dsprz/Swarm-bots/README.md

# Swarm-bots
Projet de robotique. Essaim de robots avec un chef : une araignée.
