dsprz/Swarm-bots/Rapports de séance/VU/Seance_18_VU.md

Séance 18

<p>J'ai réassemblé mon robot avec les rainures en T, qui m'a l'air beaucoup plus solide que les anciens modèles.
J'en ai aussi profité pour retirer le servomoteur qui me permettait de "coller" la pince à mon robot à travers un trou rectangulaire, parce que finalement il n'avait aucune autre utilité. Je ne l'utilisais pas dans mes tests et je ne compte pas l'utiliser plus tard. 
</p>
<p>Du coup, je dois maintenant trouver une solution pour accrocher ma pince. Ma première idée était d'utiliser le pistolet à colle, sauf que ça ne marchait pas : la colle ne prenait pas, et même si elle prenait, je doute qu'elle aurait tenu longtemps.
Ma deuxième idée était de faire deux trous dans le support de ma pince et dans la face avant du robot, et je les assemble avec des vis. Cette idée marche beaucoup mieux: ma pince tient bien en place.
</p> 
<p>Résultat: j'économise un servomoteur et je réduis un peu la longueur et le poids totaux de ma pince, ce qui devrait jouer sur la petite inclinaison que j'avais au niveau de ma pince, et aussi sur la robustesse de mon robot</p>.
