dsprz/Swarm-bots/Rapports de séance/VU/Seance_14._VU.md

<p align="center"><h1>Séance 14</h1><p>

J'ai commencé à monter un premier récepteur. Ci-dessous le schéma électrique du récepteur :
<p align="center">
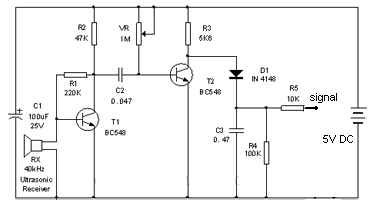
[picture p3: Rapports de séance/VU/images/Seance14/receiver.jpg]
    
</p>
<p align="center">
    <i>Figure 1: Schéma électrique du récepteur</i>
</p>

En faisant les branchements pour faire un premier test  sur la breadboard, j'ai fait beaucoup d'erreurs de branchement parce que j'ai passé beaucoup de temps à souder l'émetteur et je commençais à confondre les connections de la breadboard et celles que j'allais réaliser avec de l'étain. J'ai corrigé les erreurs de branchement.

Après avoir corrigé tous les branchements, j'ai fait mes premiers tests avec le duo émetteur-récepteur. Grâce à Ronan, j'ai réalisé que la soudure de l'émetteur avait un court-circuit. J'avais un signal qui sortait et qui semblait être bon (parce que je pensais que du fait que j'utilise un transistor légèrement différent de celui qui est sur le schéma électrique, le signal allait être un peu différent), sauf que ce n'était pas du tout le bon signal.
J'ai enlevé le court-circuit, mais il n'y avait plus de signal. Après avoir regardé les tensions sur à peu près tous les composants, j'ai vu qu'étrangement la tension aux bornes du condensateur 22nF était de 0V. J'ai désoudé ce-dernier et je l'ai remplacé par un nouveau.
La tension aux bornes du condensateur n'est plus de 0. Résultat : le signal en sortie de l'émetteur est parfait, comme on peut le voir en comparant les signaux suivants :

<p align="center">
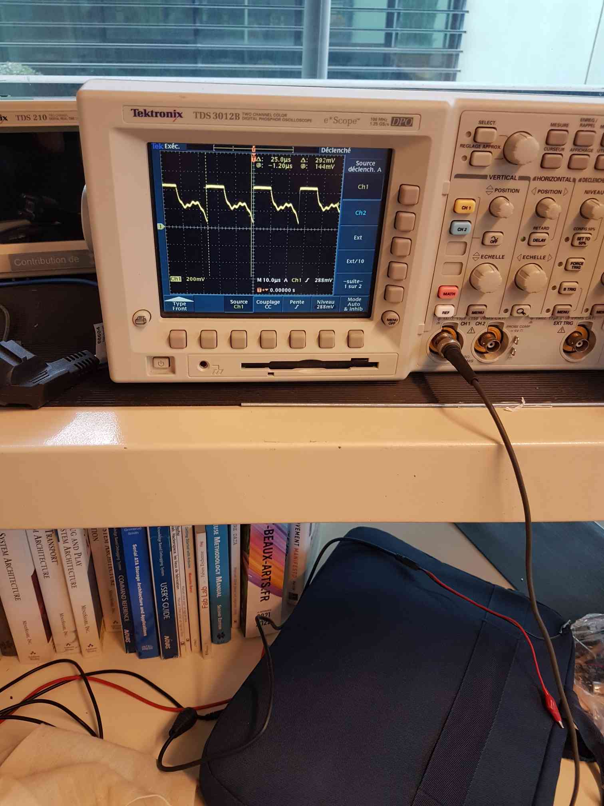
[picture p4: Rapports de séance/VU/images/Seance14/emitter_output.jpg]
    
</p>

<p align="center">
    <i>Figure 2: Signal en sortie de mon émetteur</i>
</p>

<p align="center">
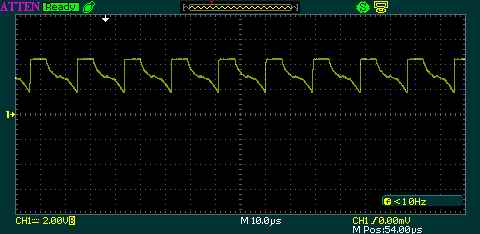
[picture p5: Rapports de séance/VU/images/Seance14/emitter_output_dog.jpg]
    
</p>

<p align="center">
    <i>Figure 3: Signal en sortie de l'émetteur que je suis censé avoir</i>
</p>
La différence entre les deux signaux peut s'expliquer par mes transistors qui sont différents de ceux du schéma électrique de l'émetteur (Séance 13).

En continuant les tests, en plaçant l'émetteur en face du récepteur, j'obtiens le signal ci-dessous avant la diode de l'émetteur :
<p align="center">
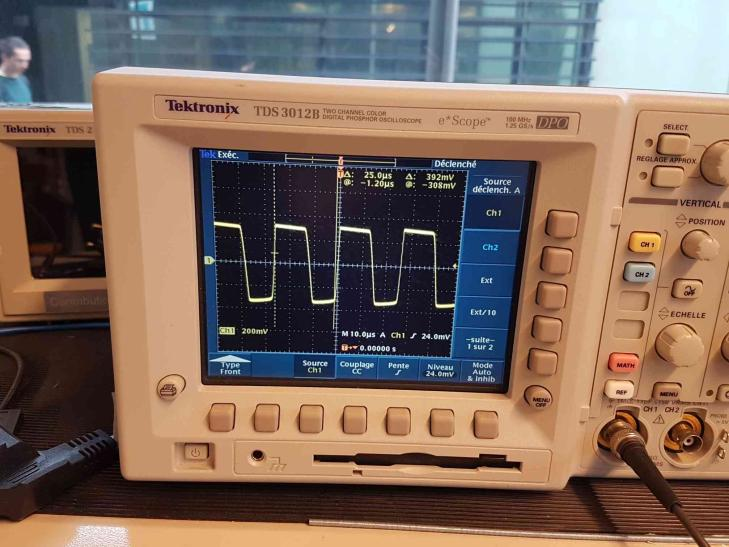
[picture p6: Rapports de séance/VU/images/Seance14/signal_received_diode_me.jpg]
    
</p>
<p align="center">
    <i>Figure 4: Signal que mon récepteur reçoit</i>
</p>

Et voici le signal que je suis censé obtenir :
<p align="center">
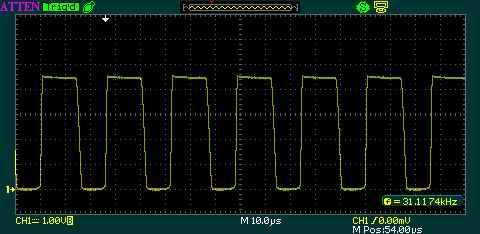
[picture p7: Rapports de séance/VU/images/Seance14/signal_received_diode_dog.jpg]
    
</p>
<p align="center">
    <i>Figure 3: Signal que je suis censé obtenir</i>
</p>

J'obtiens un résultat très satisfaisant.
Lorsque je lis le signal sur le fil Signal du schéma électrique, j'obtiens une tension qui varie en fonction de la distance entre l'émetteur et le récepteur.

Je peux alors retirer les composants de la breadboard et les souder. Après avoir fait ça, j'ai remarqué que le signal reçu faiblit trop vite. Il faut donc que je concentre les ondes, par exemple dans un tube, afin "d'amplifier la tension reçue" pour qu'elle soit perceptible par les pins analogiques d'Arduino.
En plus de ça, je dois souder de manière plus compacte les autres récepteurs, celui que je viens de souder est trop volumineux.

Je me pose des questions sur l'utilité du potentiomère 1M. Lorsque je le tourne à 0, j'obtiens un signal plus facilement perceptible que si je le tourne en direction de 1M. Je pense le remplacer par un simple fil, mais avant ça il faut que je vois avec Christian Peter.
