dsprz/Swarm-bots/Rapports de séance/VU/Seance_9_VU.pdf

## Séance 9

J’ai imprimé et monté une nouvelle pince :

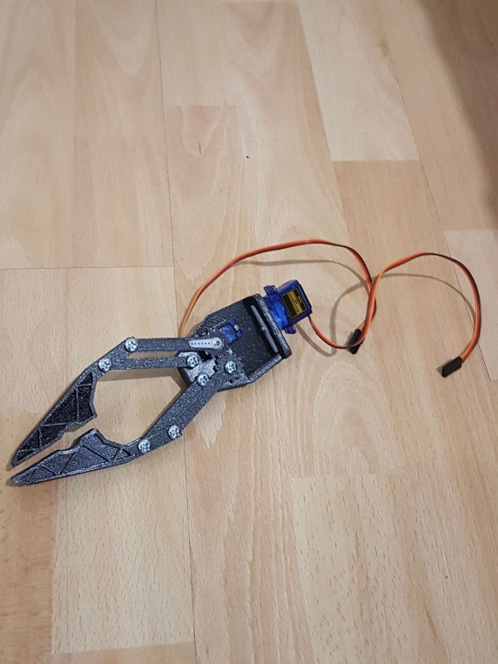
[picture p40: figure]

Figure 1 : La nouvelle pince

Puis j’ai presque fini de monter un autre robot :

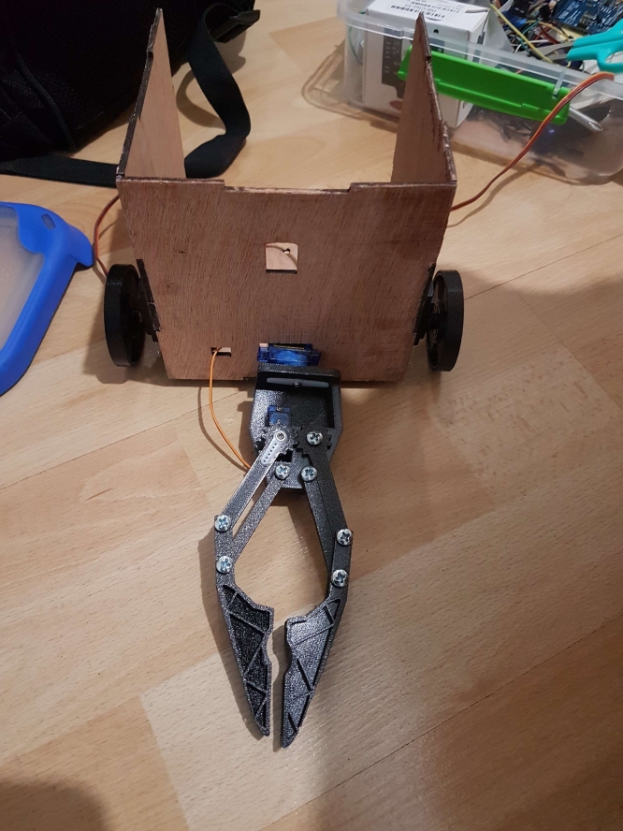
[picture p41: figure]
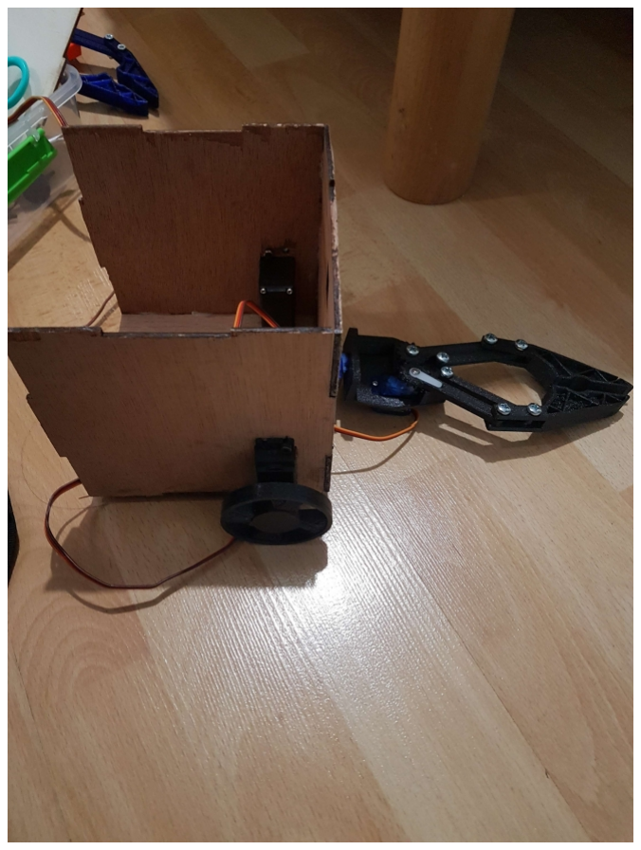
[picture p42: figure]

Figure 2 : Vue de face | Figure 3 : Vue de côté

Il est esthétiquement plus beau que le premier que j’ai monté : moins de trace de colle et le bois est moins « cassé ».
Cependant, il me manque une roue libre parce qu’il y en n’avait plus et il manque aussi les trous pour visser la Pixy et mon servo au bâti parce que j’ai oublié de les faire à la
découpe laser. Je les ferai au cutter ou à la perceuse.
J’ai maintenant 2 robots pour commencer à travailler sur les interactions dans mon essaim.
