dsprz/Swarm-bots/Rapports de séance/VU/Séance_3_VU.pdf

## Séance 3

J’ai commencé à assembler les faces latérales de ma boite et mes servomoteurs pour faire un premier robot qui puisse rouler. Une de mes impressions a cassé parce que j’ai trop forcé sur elle.

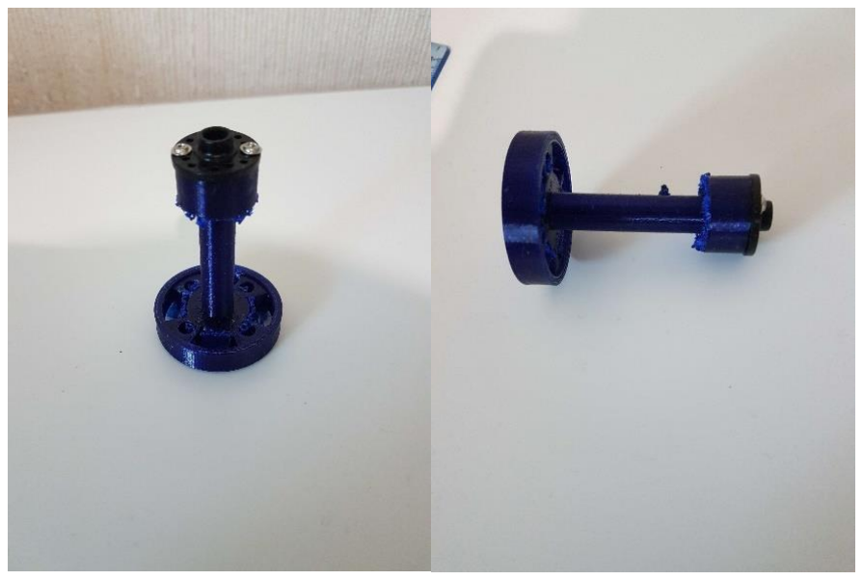
[picture p79: figure]

Figure 1 : La pièce {tige + roue+ support du servomoteur}

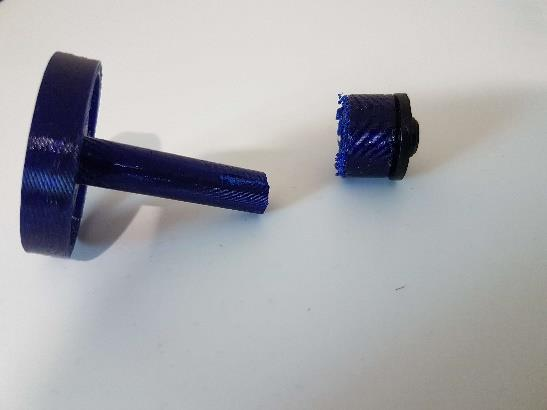
[picture p80: figure]

Figure 2 : La pièce que j’ai cassée

Après plusieurs casses, j’ai réussi à obtenir le montage suivant :

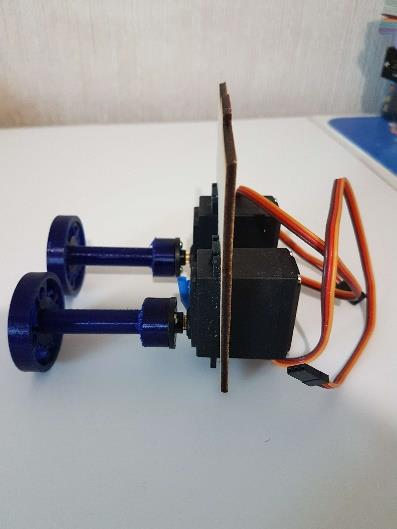
[picture p81: figure]

Figure 3 : Une face latérale montée avec deux servomoteurs RC

En assemblant une deuxième face et une base, je peux avoir le début d’un robot sur 4 roues.
