dsprz/Swarm-bots/Rapports de séance/PORCEL/Séance 1.pdf

### Rapport de la séance 1

14 Octobre 2022
PORCEL Koralie
Robotique

Lors de cette séance, on nous a donné les premiers composants de l’araignée.

-Une carte SSC-32U pour controler les servo moteurs
-Une batterie S-150-5 pour l’alimentation
-Un servomoteur TD-8135MG pour controler les pattes.
1) Modélisation 3D de la boite

J’ai commencé à modéliser en 3D la base de l’araignée qui sera faite en bois pour le prototype.

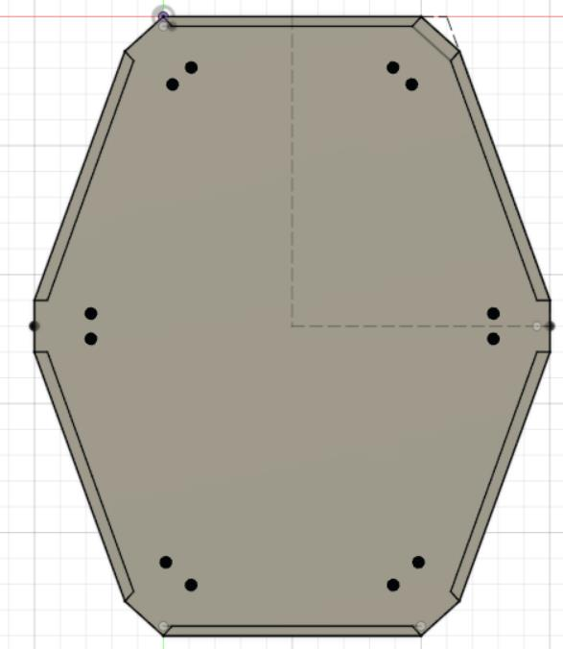
[picture p97: figure]
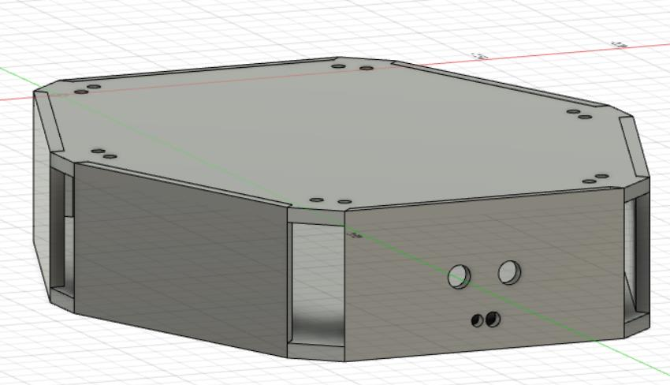
[picture p98: figure]

J’ai mis sur la face de devant, les trous pour les capteurs de distance et de proximité.

J’ai mis 6 trous corespondant à la taille d’un servomoteur pour pouvoir le fixer. De plus j’ai mis sur la face de dessus des trous pour les vis permettant de fixer les servomoteurs.

-Comme la dimension de l’alimentaion est très importante : 10 x 20 x 4 cm ; je me suis demandée si finalement tout pouvait rentrer dans la base de l’araignée. Le module pour contrôler les servomoteurs fait environ 7,5 x 6 cm et la carte Nvidia 8 x 10cm

La base faisant 20 x 24 x 4, je me suis rendue compte que tout n’allait pas rentrer

Cela faisait quelque chose comme ça :

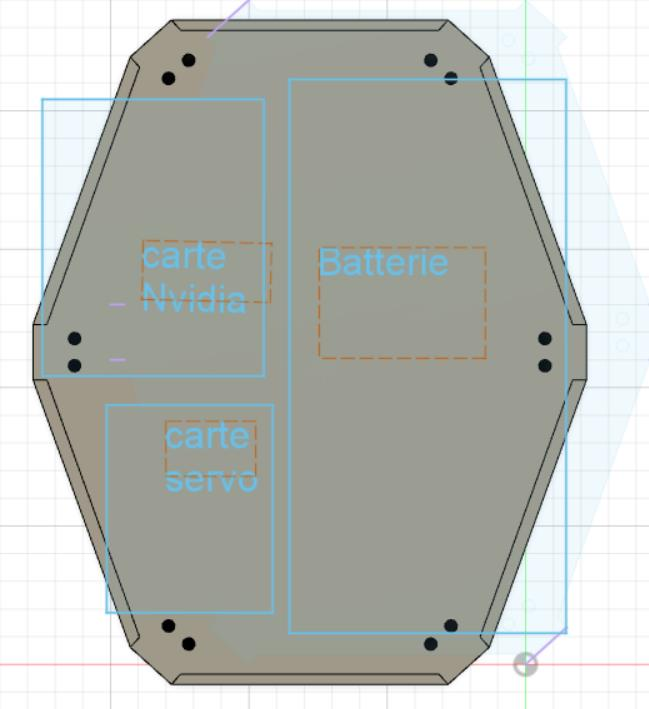
[picture p99: figure]

J’ai réfléchi si on ne pouvait pas mettre un des composants en dehors de la boite, mais cela ne serait pas pratique. Je peux également augmenter la hauteur de la boite pour tout faire rentrer par exemple la carte pour contrôler les servomoteurs à la verticale ou bien augmenter la taille de la boite.

J’ai donc choisi d’agrandir un peu la base, et décaler les servomoteurs, ils sortiront un peu plus de la boite (je voulais qu’ils soient un peu moins de la moitié dans la boite au début).

Je ne suis pas sûr que ce soit la meilleure solution car l’hexapode commence à être vraiment grand mais surtout très large, je vais donc continuer à réfléchir.

2) Modélisation 3D des pattes

Lors de cette séance, j’ai beaucoup réfléchi à comment implanter les pattes et à savoir comment elles seront. J’avais déjà fait des recherches et je savais à peu près comment je voulais qu’elles soient.

Je me suis demandé si le servomoteur est fixé à la pièce qu’il fait exercé une rotation ou bien s’il est fixé à la piece d’avant.

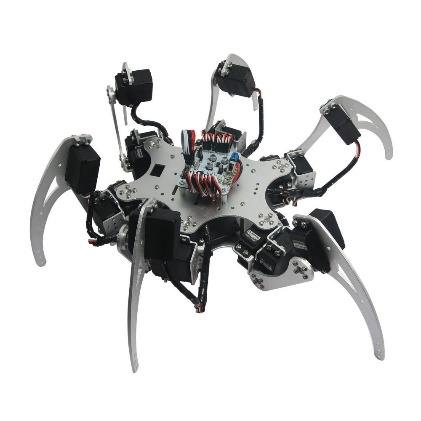
[picture p100: figure]
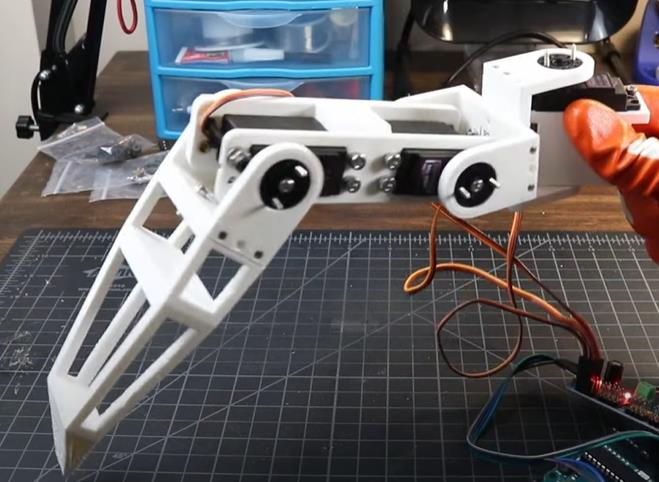
[picture p101: figure]

Servo moteur fixé à la piece | Servo moteur fixé à la piece d’avant

J’ai décidé de partir sur une patte ressemblant à la deuxième image. Que ce soit pour le positionement des servomoteurs ou le style.

En m’aidant des supports si-dessous et des dimensions de mon servomoteur, j’ai commencé la modélisation de la patte.

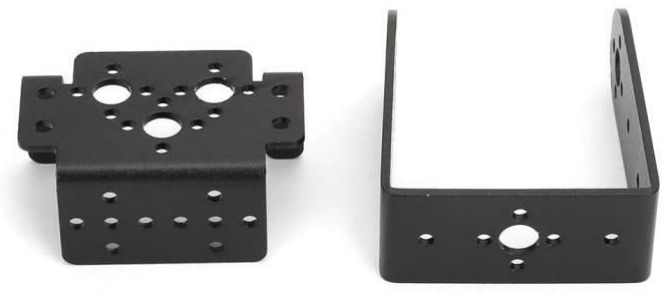
[picture p102: figure]

Je rajouterai sur la face du bas de la boite de l’hexapode, des supports pour pouvoir poser le servomoteur dessus et donc permettre une meilleure fixation et une meilleure répartition des forces du travail de rotation.

Pour pouvoir faire une rotation au servomoteur, il sera fixé à l’élement à faire tourner grâce à ceci :

Je n’ai eu le temps que de faire le premier composant de la pièce qui sera utilisée sur chaque servomoteur donc 3 fois par patte.

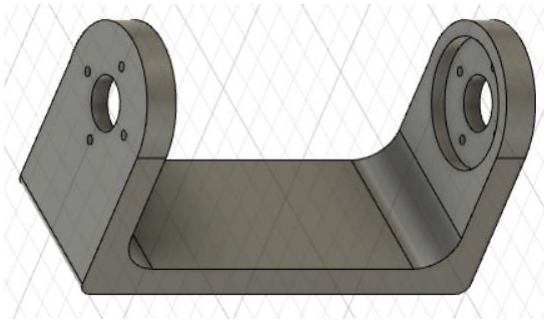
[picture p103: figure]

Premiere piece de la patte.

Pour presque toutes les valeurs, j’ai utilisé des variables pour pouvoir rapidement changer si besoin les distances ( faire cela a déjà été très utile)

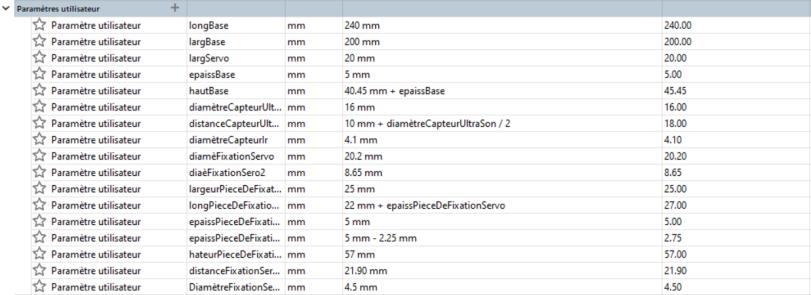
[picture p104: figure]
