dsprz/Swarm-bots/Codes/readme.md

Le dossier Main contient le code pour les petits robots de l'essaim.  
Le dossier Spider contient le code pour faire bouger l'araignée.  
Il n'y a pas encore de code pour la carte NVIDIA.
