dsprz/Swarm-bots/Rapports de séance/VU/Seance_16._VU.md

Séance 16

J'ai demonté les 6 récepteurs du projet de PEIP2. Je les ai tous testés 1 par 1 pour voir s'ils marchaient encore correctement. J'ai remarqué qu'ils n'avaient pas les même transistors que les miens, mais le signal qu'ils recevaient était très proche de ceux que j'avais déjà.
Au final ils marchent tous correctement, et puisqu'il y en avait 6, je peux directement en mettre 5 sur mon robot.
<p> 
J'ai également modélisé et imprimé un cône à base circulaire que j'ai collé sur un de mes récepteurs.
J'ai essayé de modéliser juste un tube simple (un cylindre en soit) pour un émetteur, mais pour une raison inconnue je n'arrive pas à le mettre sur PrusaSlicer, le logiciel me met un message d'erreur qui me dit que j'ai un problème avec la modélistion 3D sur Fusion360.
</p>

Il me reste 2 émetteurs à construire pour l'araignée et 2 récepteurs mes robots.
