dsprz/Swarm-bots/Pieces/files/Excellent_Arduino_Case_04c_Base.STL

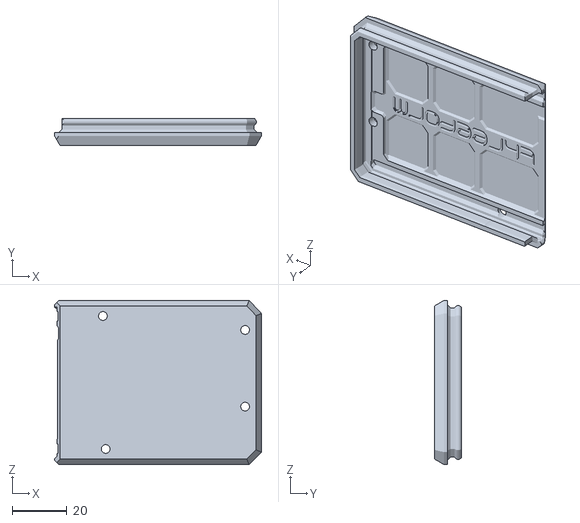
[picture p133: CAD file, 2023-04-15]
Pieces/files/Excellent_Arduino_Case_04c_Base.STL
75.6 x 9.81 x 60.0
