dsprz/Swarm-bots/Pieces/Pieces pour emetteurs recepteurs/Oreille à ultrasons v1.stl

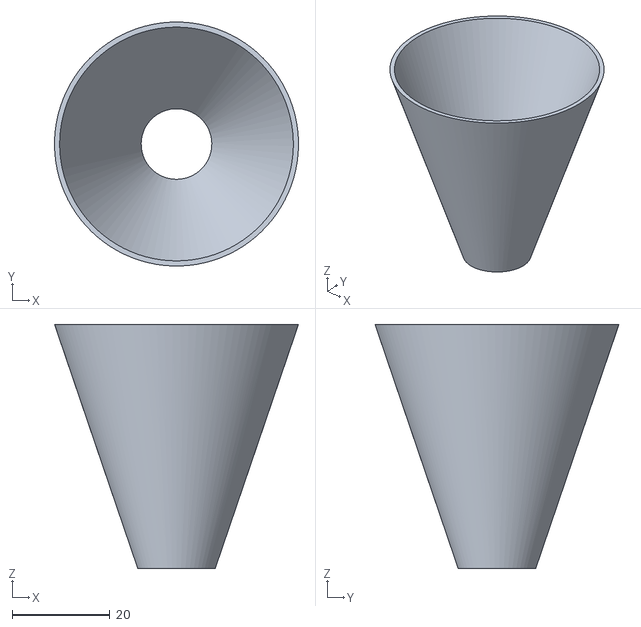
[picture p134: CAD file, 2023-03-18]
Pieces/Pieces pour emetteurs recepteurs/Oreille à ultrasons v1.stl
50.0 x 50.0 x 50.0
