dsprz/Swarm-bots/Pieces/files/Excellent_Arduino_Case_04c_Cover.STL

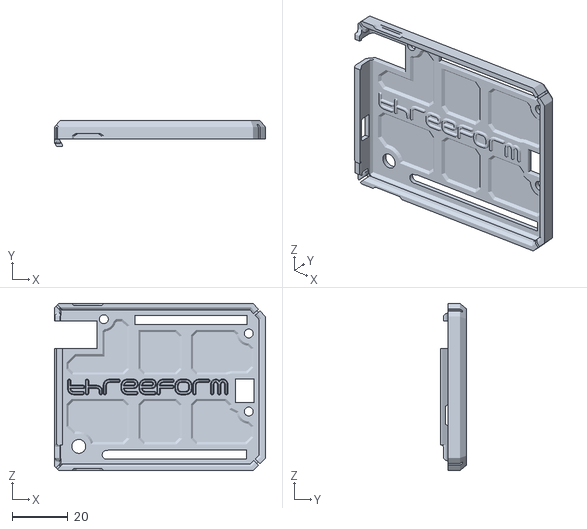
[picture p135: CAD file, 2023-04-15]
Pieces/files/Excellent_Arduino_Case_04c_Cover.STL
75.6 x 9.26 x 60.0
