dsprz/Swarm-bots/(list of files, cad)

Other CAD files:
Jimmy VU/CAO/Boitier_Arduino_2 v5.f3d
PORCEL Koralie/Fabrication/Projet fablabPORCEL.f3d
