dsprz/Swarm-bots/(commit log)

2023-02-03 Algorithme de localisation
2023-03-18 Seance 16
    [Oreille à ultrasons v1.stl, Tube à ultrason v1 L50.stl]
2023-03-25 Seance 17
    [Tube à ultrason v1 L50.stl]
2023-04-15 Seance 20: robot presque fini
    [Excellent_Arduino_Case_04c_Base.STL, Excellent_Arduino_Case_04c_Cover.STL]
2023-04-29 Ligne de + et de - sans breadboard
    Comment faire une ligne de + et de - sans utiliser de breadboard
2023-05-16 Rapport de projet
